dinhducqng/CDIO-4---Motor-3-Phase-AutoCad/bìa.docx

BỘ GIÓA DỤC VÀ DÀO TAO

TRƯỜNG ĐẠI HỌC DUY TÂN

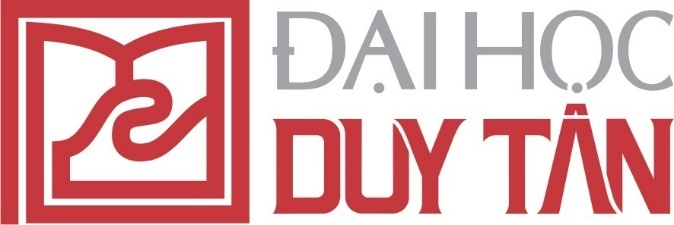
[picture p1: figure]

BÁO CÁO

Đề tài: “................................................................................................................

................................................................................................................................”

GVHD: ...................................

SVTH: …………………………………..

Lớp: …………………………………….

Khóa: …………………………………..

MSSV: ……………………………………
