dinhducqng/CDIO-4---Motor-3-Phase-AutoCad/demoooo.pdf

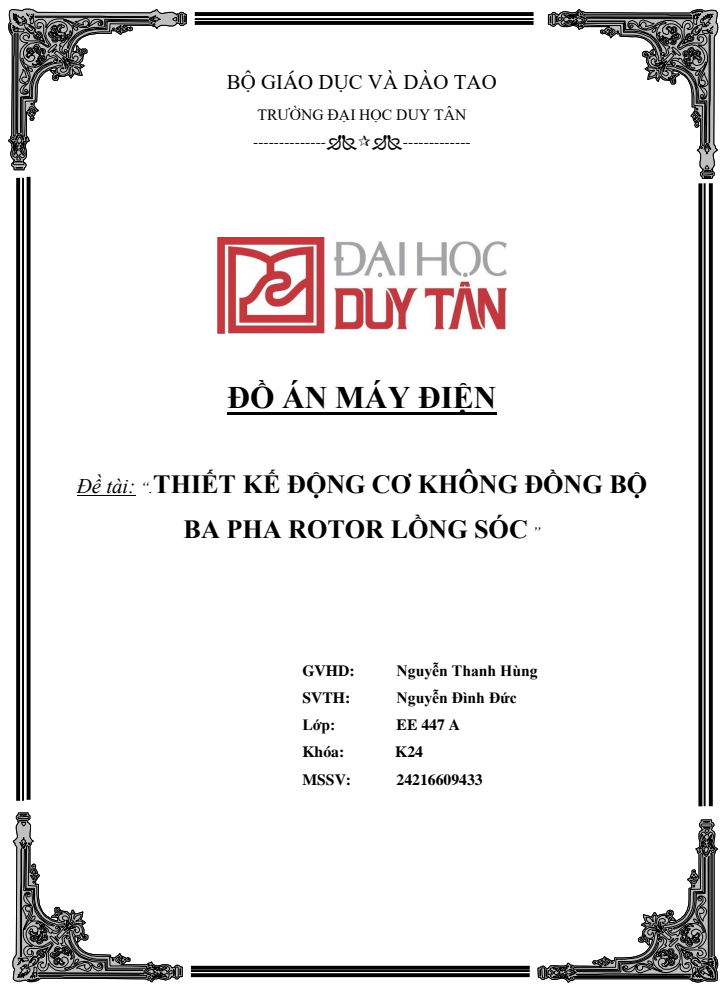
[picture p3: page 1]
GVHD:; Nguyễn Thanh Hùng; SVTH:; Nguyễn Đình Đức; Lớp:; Khóa:; MSSV:

BỘ GIÁO DỤC VÀ DÀO TAO

TRƯỜNG ĐẠI HỌC DUY TÂN

ĐỒ ÁN MÁY ĐIỆN

Đề tài: “.THIẾT KẾ ĐỘNG CƠ KHÔNG ĐỒNG BỘ

BA PHA ROTOR LỒNG SÓC ”

MỤC LỤC

1

LỜI NÓI ĐẦU

Động cơ không đồng bộ (KĐB) ba pha rôto lồng sóc được dùng phổ biến trong công

nghiệp (vì có ưu điểm là độ tin cậy tốt, giá cả thấp, trọng lượng nhẹ, kết cấu chắc chắn

và dễ bảo dưỡng), với dải công suất từ hàng trăm Watts đến vài Megawatts và là bộ

phận chính trong các hệ truyền động.

Ngày nay, hiệu suất của động cơ đã dần trở thành một trong những tiêu chí được áp

dụng trong công nghiệp. Vấn đề này đặt ra cho lĩnh vực thiết kế và chế tạo động cơ

điện là không ngừng nghiên cứu, thiết kế để tạo ra sản phẩm đạt những chỉ tiêu về

kinh tế - kỹ thuật nhằm đáp ứng yêu cầu phát triển của nền kinh tế quốc dân. Chính vì

vậy em đã chọn thực hiện đề tài : “ Thiết kế động cơ điện không đồng bộ ba pha rôto

lồng sóc” cho đồ án tốt nghiệp cuối khoá của mình.

Nôi dung đồ án gồm 7 chương:

Chương 1: Đại cương về động cơ điện không đồng bộ.

Chương 2: Xác định các kích thước chủ yếu.

Chương 3: Thiết kế stato.

Chương 4: Thiết kế rôto

Chương 5: Tính toán mạch từ và xác định tham số của động cơ ở chế độ định

mức.

Chương 6: Đặc tính làm việc và khởi động.

Chương 7: Trọng lượng vật liệu tác dụng và chỉ tiêu sử dụng.
Em xin bày tỏ lòng biết ơn các Thầy, Cô giáo mà đặc biệt là các Thầy cô giáo trong

khoa Điện – Điện Tử đã giúp đỡ chỉ bảo em tận tình trong những năm học tập tại trường Đại Học Duy Tân. Cho em gửi lời cảm ơn chân thành đến thầy giáo Nguyễn

Thanh Hùng – là người trực tiếp hướng dẫn em hoàn thành bản đồ án tốt nghiệp này.

Trong một khoảng thời gian ngắn chắc rằng bản đồ án tốt nghiệp sẽ không tránh khỏi

những thiếu sót. Em rất mong được sự chỉ dẫn của Thầy giáo, Cô giáo và các bạn. Em

xin chân thành cảm ơn.

Sinh viên

Nguyễn Đình Đức

2

CHƯƠNG 1

ĐẠI CƯƠNG VỀ ĐỘNG CƠ ĐIỆN KHÔNG ĐỒNG BỘ

### 1.1 TỔNG QUAN VỀ ĐỘNG CƠ ĐIỆN KHÔNG ĐỒNG BỘ

Máy điện không đồng bộ do kết cấu đơn giản, làm việc chắc chắn, sử dụng

và bảo quản thuận tiện, giá thành rẻ nên được sử dụng rộng rãi trong nền kinh tế

quốc dân, nhất là loại công suất dưới 100 kW.

Động cơ điện không đồng bộ rôto lồng sóc cấu tạo đơn giản, làm việc tin

cậy chiếm một số lượng khá lớn trong loại động cơ công suất nhỏ và trung bình.

Nhược điểm của động cơ này là điều chỉnh tốc độ khó khăn và dòng điện khởi

động lớn thường bằng 5-7 lần dòng điện định mức. Để bổ khuyết cho nhược điểm

này, người ta chế tạo đông cơ không đồng bộ rôto lồng sóc nhiều tốc độ và dùng

rôto rãnh sâu, lồng sóc kép để hạ dòng điện khởi động, đồng thời tăng mômen

khởi động lên.
Động cơ điện không đồng bộ rôto dây quấn có thể điều chỉnh tốc độ trong

một phạm vi nhất định, có thể tạo một mômen khởi động lớn mà dòng khởi động

không lớn lắm, nhưng chế tạo có khó hơn so với với loại rôto lồng sóc, do đó giá

thành cao hơn, bảo quản cũng khó hơn.
Động cơ điện không đồng bộ được sản xuất theo kiểu bảo vệ IP23 và kiểu

kín IP44. Những động cơ điện theo cấp bảo vệ IP23 dùng quạt gió hướng tâm đặt

ở hai đầu rôto động cơ điện. Trong các động cơ rôto lồng sóc đúc nhôm thì cánh

quạt nhôm được đúc trực tiếp lên vành ngắn mạch. Loại động cơ điện theo cấp

bảo vệ IP44 thường nhờ vào cánh quạt đặt ở ngoài vỏ máy để thổi gió ở mặt ngoài

vỏ máy, do đó tản nhiệt có kém hơn do với loại IP23 nhưng bảo dưỡng máy dễ

dàng hơn.
Hiện nay các nước đã sản xuất động cơ điện không đồng bộ theo dãy tiêu

chuẩn. Dãy động cơ không đồng bộ công suất từ 0,55 - 90 KW ký hiệu là K theo

tiêu chuẩn Việt Nam 1987-1994 được ghi trong bảng 10-1 [3]. Theo tiêu chuẩn

này, các động cơ điện không đồng bộ trong dãy điều chế tạo theo kiểu IP44.

3

Ngoài tiêu chuẩn trên còn có tiêu chuẩn TCVN 315-85, quy định dãy

công suất động cơ điện không đồng bộ rôto lồng sóc từ 110 kW-1000 kW, gồm

có công suất sau: 110,160, 200, 250, 320, 400, 500, 630, 800 và 1000 kW.

Ký hiệu của một động cơ điện không đồng bộ rôto lồng sóc được ghi theo

ký hiệu về tên gọi của dãy động cơ điện, ký hiệu về chiều cao tâm trục quay, ký

hiệu về kích thước lắp đặt.

### 1.1.1. Nguyên lý làm việc của động cơ điện không đồng bộ xoay chiều ba

pha.
Động cơ không đồng bộ bap ha có hai phần chính: stato (phần tĩnh) và

rôto (phần quay). Stato gồm có lõi thép trên đó có chứa dây quấn bap ha.

Khi đấu dây quấn ba pha vào lưới điện ba pha, trong dây quấn sẽ có các

dòng điện chạy, hệ thống dòng điện này tao ra từ trường quay, quay với tốc độ:

n1 = 60.

f1
p
Trong đó:
f1: tần số nguồn điện

p: số đôi cực từ của dây quấn

Phần quay, nằm trên trục quay bao gồm lõi thép rôto. Dây quấn rôto bao

gồm một số thanh dẫn đặt trong các rãnh của mạch từ, hai đầu được nối bằng

hai vành ngắn mạch.

Hình1.1

Từ trường quay của stato cảm ứng trong dây rôto sức điện động E, vì dây quấn stato kín mạch nên trong đó có dòng điện chạy, Sự tác dụng tương hổ

a

S

N

Fd

Fd

Ic n

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
giữa các thanh dẫn mang dòng điện với từ trường của máy tạo ra các lực điện từ

Fđt tác dụng lên thanh dẫn có chiều xác định theo quy tắc bàn tay trái.

Tập hợp các lực tác dụng lên thanh dẫn theo phương tiếp tuyến với bề măt rôto

tạo ra mômen quay rôto. Như vậy, ta thấy điện năng lấy từ lưới điện đã được

biến thành cơ năng trên trục động cơ. Nói cách khác, động cơ không đồng bộ là

một thiết bị điện từ, có khả năng biến điện năng lấy từ lưới điện thành cơ năng

đưa ra trên trục của nó. Chiều quay của rôto là chiều quay của từ trường, vì vậy

phụ thuộc vào thứ tự pha của điện áp lưới đăt trên dây quấn stato. Tốc độ của

rôto n2 là tốc độ làm việc và luôn luôn nhỏ hơn tốc độ từ trường và chỉ trong

trường hợp đó mới xảy ra cảm ứng sức điện động trong dây quấn rôto. Hiệu số

tốc độ quay của từ trường và rôto được đặc trưng bằng một đại lượng gọi là hệ

số trượt s:

s =

n1 − n2
n1
Khi s=0 nghĩa là n1= n2, tốc độ rôto bằng tốc độ từ trường, chế độ này gọi

là chế độ không tải lý tưởng (không có bất cứ sức cản nào lên trục). Ở chế độ

không tải thực, s≈0 vì có một ít sức cản gió, ma sát do ổ bi …

Khi hệ số trượt bằng s =1, lúc đó rôto đứng yên (n2=0), momen trên trục

bằng momen mở máy.

Hệ số trượt ứng với tải định mức gọi là hệ số trựơt định mức. Tương ứng

với hệ số trượt này gọi tốc độ động cơ gọi là tốc độ định mức.

Tốc độ động cơ không đồng bộ bằng:

n2 = n1. (1 − s)
Một đăc điểm quan trọng của động cơ không đồng bộ là dây quấn stato

không được nối trực tiếp với lưới điện, sức điện động và dòng điện trong rôto có

được là do cảm ứng, chính vì vậy người ta cũng gọi động cơ này là động cơ cảm

ứng.
Tần số dòng điện trong rôto rất nhỏ, nó phụ thuộc vào tốc độ trựơt của rôto so

với từ trường:

5

f2 = p.

n1 − n2
60 =

p. n1. (n1 − n2)
60. n1

= s. f1

Động cơ không đồng bộ có thể làm việc ở chế độ máy phát điện nếu ta

dùng một động cơ khác quay nó với tốc độ cao hơn tốc độ đồng bộ, trong khi

các đầu ra của nó được nối với lưới địện. Nó cũng có thể làm việc độc lập nếu

trên đầu ra của nó được kích bằng các tụ điện.

Động cơ không đồng bộ có thể cấu tạo thành động cơ một pha. Động cơ

một pha không thể tự mở máy được, vì vậy để khởi động động cơ một pha cần

có các phần tử khởi động như tụ điện, điện trở …

### 1.1.2. Cấu tạo của động cơ không đồng bộ

Động cơ không đồng bộ về cấu tạo được chia làm hai loại: Động cơ

không đồng rôto lồng sóc và động cơ rôto dây quấn. Stato của hai loại là như

nhau. Ở phần đồ án này ta chỉ nghiên cứu rôto lồng sóc .

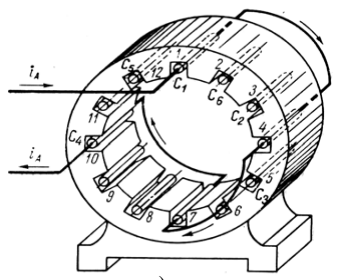
[picture p4: figure]
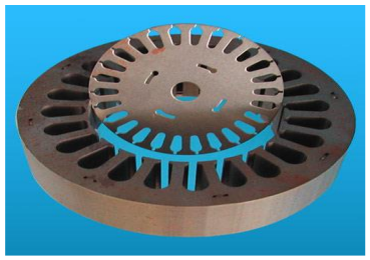
[picture p5: figure]

a) b)
Hình 1.2 kết cấu stato máy điện không đồng bộ
a) lá thép stato
b) lõi thép stato.
a) Stato (phần tĩnh)

Stato bao gồm vỏ máy, lõi thép và dây quấn.

- Vỏ máy
Vỏ máy là nơi cố định lõi sắt, dây quấn và đồng thời là nơi ghép

nối nắp hay gối đỡ trục. Vỏ máy có thể làm bằng gang, nhôm hay thép.

6

Để chế tạo vỏ máy người ta có thể đúc, hàn, rèn. Vỏ máy có hai

kiểu: vỏ kiểu kín và vỏ kiểu bảo vệ. Vỏ máy kiểu kín yêu cầu phải có

diện tích tản nhiệt lớn người ta làm nhiều gân tản nhiệt trên bề mặt vỏ

máy. Vỏ kiểu bảo vệ thường có bề mặt ngoài nhẵn, gió làm mát thổi trực

tiếp trên bề mặt ngoài lõi thép và trong vỏ máy.

Hộp cực là nơi để dấu điện từ lưới vào. Đối với động cơ kiểu kín

hộp cực yêu cầu phải kín, giữa thân hộp cực và vỏ máy với nắp hộp cực

phải có giăng cao su. Trên vỏ máy còn có bulon vòng để cẩu máy khi

nâng hạ, vận chuyển và bulon tiếp mass.

- Lõi sắt

Lõi sắt là phần dẫn từ. Vì từ trường đi qua lõi sắt là từ trường quay,

nên để giảm tổn hao lõi sắt được làm từ những lá thép kỹ thuật điện dày

0,5mm bề mặt các lá thép có phủ một lớp sơn cách điện mỏng để giảm

tổn hao do dòng điện xoáy gây nên, các lá thép được ép lại thành khối.

Yêu cầu lõi sắt là phải dẫn từ tốt, tổn hao sắt nhỏ và chắc chắn.

- Dây quấn

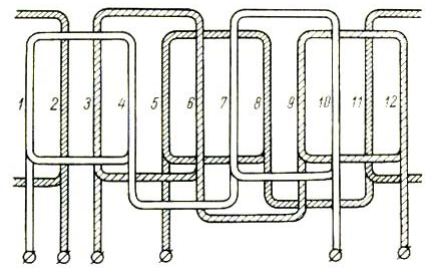
[picture p6: figure]

Hình 1.3. Dây quấn stato.

Dây quấn stato được đặt vào rãnh của lõi sắt và được cách điện tốt với lõi

sắt. Dây quấn đóng vai trò quan trọng của máy điện vì nó trực tiếp tham gia các

quá trình biến đổi năng lượng điện năng thành cơ năng hay ngược lại, đồng thời

7

về mặt kinh tế thì giá thành của dây quấn cũng chiếm một phần khá cao trong

toàn bộ giá thành máy.
b) Phần quay (Rôto)

Rôto của động cơ không đồng bộ gồm lõi sắt, dây quấn và trục (đối với

động cơ rôto dây quấn còn có vành trượt).

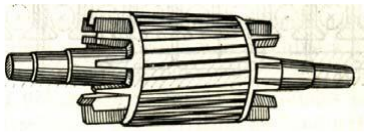
[picture p7: figure]

a) b )
Hình 1.4. Cấu tạo rôto động cơ không đồng bộ.
a) Dây quấn lồng sóc. b) Lõi thép rôto;

Lõi sắt

Lõi sắt của rôto bao gồm các lá thép kỹ thuật điện như của stato,

điểm khác biệt ở đây là không cần sơn cách điện giữa các lá thép vì tần số

làm việc trong rôto rất thấp, chỉ vài Hz, nên tổn hao do dòng phu co trong

rôto rất thấp. Lõi sắt được ép trực tiếp lên trục máy hoặc lên một giá rôto

của máy. Mặt ngoài của lõi thép đựợc dập rãnh (hình 1.2b) để đặt dây

quấn và ở giữa có dập lỗ để lắp trục.

Dây quấn rôto

Phân làm 2 loại chính: loại kiểu rôto dây quấn và loại kiểu rôto

lồng sóc.

Loại rôto dây quấn

Rôto dây quấn giống như giây quấn stato. Máy điện kiểu trung

bình trở lên dùng dây quấn kiểu sóng 2 lớp, vì bớt những giây đầu nối,

kết cấu trên dây quấn rôto trở nên chặt chẽ. Máy điện cỡ nhỏ dùng dây

quấn đồng tâm 1 lớp. Dây quấn 3 pha của rôto thường đấu hình sao.

8

Đặt điểm của loai động cơ kiểu dây quấn có thể thông qua chổi

than để đưa điện trở phụ hay suất điện động phụ vào mạch rôto để

tạo tính năng mở máy, điều chỉnh tốc độ hay cải thiện hệ số công

suất của máy.

Loại rôto lồng sóc

Kết cấu của loại dây quấn này rất khác với dây quấn stato (hình

1.4a). Trong mỗi rãnh của lõi sắt rôto, đặt các thanh dẫn bằng đồng hay

nhôm dài khỏi lõi sắt và được nối tắt lại ở hai đầu bằng hai vòng ngắn

mạch bằng đồng hay nhôm. Nếu là rôto đúc nhôm thì trên vành ngắn

mạch còn có các cánh khoáy gió.
Rôto thanh đồng được chế tạo từ đồng hợp kim có điện trở suất cao

nhằm mục đích nâng cao mô men mở máy và giảm tổn hao.

Để cải thiện tính năng mở máy, đối với máy có công suất lớn,

người ta làm rãnh rôto sâu hoặc dùng lồng sóc kép. Đối với máy điện cỡ

nhỏ, rãnh rôto được làm chéo góc so với tâm trục.
Dây quấn lồng sóc không cần cách điện với lõi sắt.

Trục

Trục máy điện mang rôto quay trong lòng stato, vì vậy nó cũng là một chi tiết rất quan trọng. Trục của máy điện tùy theo kích thước có thể

được chế tạo từ thép cacbon từ 5 đến 45.

Trên trục của rôto có lõi thép, dây quấn, và quạt gió.

### 1.1.3. Khe hở

Vì rôto là một khối tròn nên khe hở đều. Khe hở trong máy điện

không đồng bộ rất nhỏ (0,2÷1 mm trong máy cỡ nhỏ và vừa) để hạn chế

dòng từ hóa, nhờ đó hệ số công suất của máy cao hơn.

### 1.1.4 Phân loại:

Kết cấu của những máy điện hiện nay được định hình theo cách

bảo vệ, cách lắp ghép, thông gió, đặc tính của môi trường bên ngoài…

9

a) Phân loại theo phương pháp bảo vệ máy đối với môi trường bên ngoài

Cấp bảo vệ máy có ảnh hưởng rất lớn đến kết cấu của máy. Cấp bảo vệ được

ký hiệu bằng chữ IP và hai chữ số kèm theo, trong đó chữ số thứ nhất chỉ mức

độ bảo vệ chống sự tiếp xúc của người và các vật khác rơi vào máy, được chia

làm 7 cấp đánh số từ 0 đến 6 ,trong đó số 0 chỉ rằng máy không được bảo vệ

(kiểu hở hoàn toàn) còn số 6 chỉ rằng máy được bảo vệ hoàn toàn không cho

người tiếp xúc ,đồ vật và bụi không lọt vào, chữ số thứ hai chỉ mức độ bảo vệ

chống nước vào máy gồm cấp đánh số từ 0 đến 8, trong đó số 0 chỉ rằng máy

không được bảo vệ còn số 8 chỉ máy có thể ngâm trong nước trong thời gian vô

hạn định.
Thường có thói quen chia cấp bảo vệ theo phương pháp làm nguội máy.

Theo cách này máy điện được chia thành các kiểu kết cấu sau:

Kiểu hở

Loại này không có trang bị bảo vệ sự tiếp xúc tự nhiên các bộ phận

quay và bộ phận mang điện, cũng không có trang bị bảo vệ các vật bên ngoài rơi vào máy. Loại này được chế tạo theo kiểu tự làm nguội. Theo cấp

bảo vệ thì đây là loại IP00. Loại này thường đặt trong nhà có người trông coi và không cho người ngoài đến gần.

Kiểu bảo vệ

Có trang bị bảo vệ chống sự tiếp xúc ngẫu nhiên các bộ phận quay

hay mang điện, bảo vệ các vật ở ngoài hoặc nước rơi vào theo các góc độ khác nhau. Loại này thường là tự thông gió. Theo cấp bảo vệ thì kiểu này

thuộc các cấp bảo vệ từ IP11 đến IP33

Kiểu kín

Là loại máy mà không gian bên trong máy và môi trường bên ngoài máy được cách ly. Tùy theo mức độ kín mà cấp bảo vệ là từ IP44 trở lên.

Kiểu kín thường là tự thông gió bằng cách thổi gió ở mặt ngoài vỏ máy hay

thông gió độc lập bằng cách đưa gió vào trong máy bằng đường ống.

Thừơng dùng loại này ở môi trường nhiều bụi, ẩm ướt …

10

Kiểu bảo vệ đặc biệt như loại chống nổ, bảo vệ chống môi trường hóa

chất.

b) Phân loại theo cách lắp đặt

Theo cách lắp đặt máy, ký hiệu chữ IM kèm theo 4 chữ số tiếp theo. Ở

đây, chữ số thứ nhất chỉ kiểu kết cấu gồm 9 số đánh từ 1 đến 9 trong đó số 1 chỉ

ổ bi được lắp trên nắp máy và số 9 chỉ cách lắp đặt biệt. Chữ số thứ hai và ba

chỉ cách thức lắp đặt và hướng của trục máy. Số thứ tư chỉ kết cấu của đầu trục

gồm 9 loại đánh số từ 0 đến 8 trong đó số 0 chỉ máy có một đầu trục hình trụ, số

8 chỉ đầu trục có các kiểu đặc biệt khác.

### 1.1.5. Công dụng

Máy điện không đồng bộ là máy điện chủ yếu dùng làm động cơ điện. Do

kết cấu đơn giản, làm việc chắc chắn, hiệu quả cao, giá thành rẻ, dễ bảo quản …

Nên động cơ không đồng bộ là loại máy điện được sử dụng rộng rãi nhất trong

các ngành kinh tế quốc dân với công suất vài chục W đến hàng chục kW. Trong

công nghiệp thường dùng máy điện không đồng bộ làm nguồn động lực cho

máy cán thép loại vừa và nhỏ, động lực cho các máy công cụ ở các nhà máy công nghiệp nhẹ… Trong hầm mỏ dùng làm máy tưới hay quạt gió. Trong nông

nghiệp dùng làm máy bơm hay máy gia công nông phẩm. Trong đời sống hàng

ngày, máy điện không đồng bộ cũng đã chiếm một vị trí quan trọng như quạt

gió, động cơ trong tủ lạnh, máy giặt, máy bơm nước … nhất là loại rôto lồng

sóc. Tóm lại sự phát triển của nền sản suất điện khí hóa, tự động hóa và sinh

hoạt hằng ngày, phạm vi của máy điện không bộ ngày càng được rộng rãi.

Máy điện không đồng bộ có thể dùng làm máy phát điện, nhưng đặc tính

không tốt so với máy điện đồng bộ, nên chỉ trong vài trường hợp nào đó (như

trong quá trình điện khí hóa nông thôn) cần nguồn điện phụ hay tạm thời thì nó

cũng có một ý nghĩa rất quan trọng.

### 1.1.6. Các đại lượng định mức

Cũng như tất cả các loại động cơ điện khác, động cơ điện không đồng bộ

có các trị số định mức đặc trưng cho đều kiện kỹ thuật của máy. Các trị số này

11

do nhà máy thiết kế, chế tạo quy định ghi trên nhãn máy. Vì động cơ điện không

đồng bộ chủ yếu làm việc ở chế độ động cơ điện nên trên nhãn máy ghi các trị

số định mức của động cơ điện khi tải định mức. Các trị số đó thường bao gồm:

Công suất có ích trên trục | Pđm
Điện áp dây stato | U1đm
Dòng điện dây stato | I1đm
Tần số dòng điện stato | f
Tốc độ quay rôto | nđm
Hệ số công suất | cosρdm
Hiệu suất | ηdm

### 1.2 YÊU CẦU CỦA THIẾT KẾ ĐỘNG CƠ KĐB BA PHA RÔTO LỒNG

SÓC.

### 1.2.1. Nhiệm vụ và phạm vi thiết kế:

Nhiệm vụ thiết kế được xác định từ hai yêu cầu sau :

Yêu cầu từ phía nhà nước, bao gồm các tiêu chuẩn nhà nước, các yêu cầu

kỹ thuật do nhà nước quy định.
Yêu cầu từ phía nhà máy và người tiêu dùng thông qua các hợp đồng ký

kết.

Nhiệm vụ của người thiết kế là đảm bảo tính năng kỹ thuật của sản phẩm

đạt các tiêu chuẩn nhà nước quy định để tìm khả năng hạ giá thành để đạt

hiệu quả kinh tế cao nhất, nói tóm lại là đạt chỉ tiêu kinh tế kỹ thuật cao.

### 1.2.2. Các bước thiết kế gồm có :

Thiết kế điện từ :

Nhiệm vụ của tính toán điện từ một động cơ điện không đồng bộ rôto

lồng sóc là lựa chọn và tính toán kích thước của lõi sắt stato, rôto, kích thước

dây quấn sao cho máy đạt được tính năng mà tiêu chuẩn đã quy định. Trong giai

đoạn này, người thiết kế xác định một phương án điện từ hợp lý, có thể tính

bằng tay, có thể nhờ vào máy tính. Quá trình này sẽ tiến hành tính toán, thiết kế

các thành phần:

12

Xác định các kích thước chủ yếu.

Thiết kế stato.

Thiết kế rôto.

Xác định tham số của động cơ điện ở chế độ định mức.

Tính toán đặc tính làm việc và khởi động.
Thiết kế kết cấu:

Trong giai đoạn này phải tiến hành tính toán nhiệt để xác định kết

cấu cụ thể về phương thức thông gió và làm nguội, kết cấu cụ thể

về cách bôi trơn ổ đỡ, kết cấu thân máy và nắp máy.

Để chế tạo được động cơ không đồng bộ rôto lồng sóc còn phải qua các

khâu thiết kế sau :

Thiết kế thi công, có nhiệm vụ vẽ tất cả các bản vẽ lắp ráp và chi

tiết.

Thiết kế khuôn mẫu và gá lắp dùng trong gia công các chi tiết của

máy.
Thiết kế công nghệ, dùng để kiểm tra công nghệ trong quá trình gia

công.

### 1.2.3. Vật liệu thường dùng trong thiết kế :

Khi thiết kế động cơ không đồng bộ rôto lồng sóc, vấn đề chọn vật liệu

để chế tạo động cơ có một vai trò rất quan trọng và ảnh hưởng rất lớn đến giá

thành và tuổi thọ làm việc của nó.

Ta có các loại vật liệu sau:
a. Vật liệu dẫn từ:

Để chế tạo các phần của hệ thống mạch từ của động cơ, người ta thường

dùng các loại thép lá kỹ thuật điện hay còn gọi là tôn silíc. Hàm lượng silíc trong thép lá kỹ thuật điện có ảnh hưởng quyết định đến tính năng của nó. Cho

silíc vào thép có thể làm cho điện trở suất tăng cao, do đó hạn chế được dòng

điện xoáy nên tổn hao thép sẽ thấp xuống, nhưng khi có silíc thì cường độ từ

13

cảm cũng hạ thấp, độ cứng và độ giòn cũng tăng lên, vì vậy lượng silíc trong

thép nói chung không vượt quá 4,5%.
Trong lõi thép có từ trường biến thiên, khi mật độ từ thông và tần số biến

thiên không đổi thì tổn hao vì dòng điện xoáy của đơn vị thể tích lõi thép

tỷ lệ bình phương với chiều dày lá thép, vì vậy trong đại bộ phận máy

điện đều dùng tôn silíc dày 0,5mm. Chỉ trong trường hợp đặc biệt mới

dùng tôn dày 0,35mm.

Tùy theo công nghệ cán, người ta chia tôn silíc thành 2 loại:
Tôn cán nóng: Loại tôn này có lịch sử lâu đời, hiện nay vẫn còn sản xuất

nhiều. Tùy theo hàm lượng silíc mà người ta phân ra loại ít silíc (

và nhiều silíc (>2,8%).

Tôn cán nguội: So với tôn cán nóng, tôn cán nguội có nhiều ưu điểm như

tổn hao nhỏ, cường độ từ cảm cao, chất lượng bề mặt tốt, độ bằng phẳng

tốt nên hệ số ép chặt lá tôn cao, có thể sản xuất thành cuộn, do đó các

nước phát triển đều dùng tôn cán nguội thay thế tôn cán nóng. Tùy theo

sự sắp xếp các tinh thể silíc trong tôn cán nguội mà phân thành hai loại:

đẳng hướng và dị hướng. Ở tôn silíc cán nguội dị hướng thì theo chiều

cán, suất dẫn từ cao (với cường độ từ trường H = 25A/cm, mật độ từ

thông B có thể đạt 1,7-1,85T), suất tổn hao nhỏ, nhưng theo chiều vuông

góc với chiều cán thì tính năng kém đi nhiều, có khi không bằng cả tôn

cán nóng.
b. Vật liệu dẫn điện:

Trong ngành chế tạo máy điện, người ta chủ yếu dùng đồng tinh

khiết với tạp chất không quá 0,1% làm vật liệu dẫn điện vì điện trở suất

của đồng chỉ kém bạc. Ngoài đồng ra còn dùng nhôm với tạp chất không

quá 0,5%, đồng thau và đồng đen.

c. Vật liệu kết cấu
- Kim loại đen:

≤ 2,8%)

14

Kim loại đen thường dùng là gang và thép. Gang vừa rẻ tiền lại dễ đúc,

do đó được dùng nhiều, nhất là dùng để đúc các hình mẫu phức tạp như vỏ và

nắp máy điện không đồng bộ.

Thép dùng làm vật liệu kết cấu thường là thép định hình. Thép có tiết

diện tròn dùng để chế tạo trục máy và các chi tiết khác có tiết diện tròn. Tùy

theo lực tác dụng lên từng chi tiết của máy mà người ta dùng nhiều loại thép

khác nhau.

- Kim loại màu:
Thường dùng hợp kim nhôm để chế tạo các chi tiết và bộ phận của máy

mà trọng lượng cần giảm tối đa.

- Vật liệu chất dẻo:

Chất dẻo hiện nay được dùng nhiều để chế tạo các chi tiết trong máy điện

ít chịu lực cơ học và nhiệt. Chất dẻo có ưu điểm là nhẹ, dễ gia công và không bị

gỉ.

d.Vật liệu cách điện:
Vật liệu cách điện là một trong những vật liệu chủ yếu dùng để chế tạo

động cơ. Khi thiết kế động cơ, chọn vật liệu cách điện là một khâu rất quan

trọng vì phải đảm bảo động cơ làm việc tốt với tuổi thọ nhất định, đồng thời giá

thành của nó lại không cao. Khi chọn vật liệu cách điện cần chú ý những điểm

sau:
Vật liệu cách điện phải có độ bền cao, chịu tác dụng về cơ học tốt, chịu

nhiệt và dẫn điện tốt lại ít thấm nước.

Gia công dễ dàng, đủ mỏng để đảm bảo hệ số lấp đầy rãnh cao.

Phải chọn vật liệu cách điện có tính cách điện cao để đảm bảo thời gian

làm việc ít nhất của máy là 15-20 năm trong điều kiện làm việc bình thường,

đồng thời đảm bảo giá thành của động cơ không cao.

Một trong những yếu tố cơ bản nhất làm giảm tuổi thọ của vật liệu cách

điện là nhiệt độ. Nếu nhiệt độ vượt quá nhiệt độ cho phép thì chất điện môi, độ

bền cơ của vật liệu giảm đi nhiều, dẫn đến sự già hóa nhanh chất cách điện.

15

### 1.3. CÁC THÔNG SỐ BAN ĐẦU

Công suất định mức: Pđm = 4kW

Điện áp định mức: Uđm = 380/220V Tần số định mức: fđm = 50Hz

Cách đấu dây: Y/Δ

Tốc độ đồng bộ: n1 = 3000 vòng/phút

Kiểu máy: Máy kiểu kín

Cấp bảo vệ: IP44

Cấp cách điện: Cách điện cấp B

Chế độ làm việc: Liên tục

Kết cấu rôto: Rôto lồng sóc

Chiều cao tâm trục:

Tra Bảng IV. 2, phụ lục IV [3] chiều cao tâm trục theo dãy công

suất của động cơ điện KĐB rôto lồng sóc 4A (Nga) kiểu IP44 cấp cách

điện B là h = 112 mm
Hiệu suất và hệ số công suất:

Tra Bảng 10-1 [3] hiệu suất và cosφ dãy động cơ điện KĐB 3K ứng với

công suất Pđm=4 kW và tốc độ nđb=3000 vòng/phút ta có hiệu suất:η =

86,5% và hệ số công suất: Cosφ = 0,89

Bội số momen cực đại:

Tra bảng 10-10 [3] bội số momen cực đại mmax của dãy động cơ 3K ta có:

mmax =

Mmax

Mđm

= 2,2

Bội số momen khởi động:

Theo bảng 10-11 [3] bội số momen khởi động dãy động cơ điện 3K ta

chọn:

mk =

Mk

Mđm

= 2

Bội số dòng khởi động:

Tra bảng 10-12 [3 ] bội số dòng khởi động dãy động cơ điện 3K ta có:

16

ik= Imax/I đm=7,5

17

CHƯƠNG 2

XÁC ĐỊNH CÁC KÍCH THƯỚC CHỦ YẾU

Những kích thước chủ yếu của động cơ điện không đồng bộ là đường

kính trong stato D và chiều dài lõi sắt l. Mục đích của việc chọn kích thước này

là để chế tạo ra máy kinh tế hợp lý nhất mà tính năng phù hợp với tiêu chuẩn

nhà nước. Tính kinh tế của máy không chỉ là vật liệu sử dụng đểû chế tạo ra

máy mà còn xét đến quá trình chế tạo trong nhà máy, như tính thông dụng của

các khuông dập ,vật đúc, các kích thước và chi tiết tiêu chuẩn hoá …

### 2.1. Số đôi cực từ ( p ):

p =

60.f
n1

=

60.50
3000

= 1

trong đó:
n1 : Tốc độ đồng bộ (vòng/phút)

f : tần số (Hz)

### 2.2. Đường kính ngoài stator (Dn):

Đường kính ngoài Dn có liên quan mật thiết với kết cấu động cơ, cấp cách

điện và chiều cao tâm trục h đã được tiêu chuẩn hóa. Vì vậy thường chọn Dn

theo h. Ở nước ta hay dùng quan hệ giữa đường kính ngoài và chiều cao tâm

trục h của các động cơ điện không đồng bộ Hungary dãy VZ cách điện cấp E và

của Nga dãy 4A cách điện cấp F.

Với chiều cao tâm trục h = 112 mm. Theo bảng 10.3 [1] ta có đường kính

chuẩn:

Dn = 170 (mm)= 17,0 (cm)

### 2.3. Đường kính trong stato ( D):

Ta có: D = kD . Dn

Theo bảng 10.2 với 2p = 2 ta có kD = 0,52 ÷ 0,58

Vậy:

| D = kD . Dn = ( 0,52 ÷ 0,58 ) .17 = 8,84 ÷ 9,86 (cm)
| Chọn: D = 9,8 (cm)

18

### 2.4. Công suất tính toán (P') :

P' = kE.P
η.cos φ

=

0,98.4
0,865.0,89

= 5,091 (kW)

Trong đó :
kE là hệ số công suất định mức.

Chọn kE = 0,98 theo hình 10-2 [1].

### 2.5. Chiều dài của lõi sắt stato (l1):

Chiều dài của lõi sắt stato được xác định:

l1 =

6,1.10

7
. P

′
αδ. ks

. kd. A. Bδ.D². n

trong đó:
kd : hệ số dây dẫn

αδ : hệ số cung cực từ

ks : hệ số dạng sóng

A : Tải điện từ

Bδ : Mật độ từ thông khe hở không khí

Chọn sơ bộ :

kd = 0,9 , theo trang 231 [1]

αδ =

2
π

= 0,64

kS =

π
2√2

= 1,11

Việc chọn A và Bδ ảnh hưởng rất nhiều đến kích thước chủ yếu của D và

l. Đứng về mặt tiết kiệm vật liệu thì nên chọn A và Bδ lớn, nhưng nếu A và Bδ

quá lớn thì tổn hao đồng và sắt tăng lên, làm máy quá nóng, ảnh hưởng đến tuổi

thọ sử dụng máy. Do đó khi chọn A và Bδ cần xét đến chất liệu vật liệu sử dụng.

Nếu sử dụng vật liệu sắt từ tốt (có tổn hao ít hay độ từ thẩm cao) thì có thể chọn

Bδ lớn. Dùng dây đồng có cấp cách điện cao thì có thể chọn A lớn. Ngoài ra tỷ

số giữa A và Bδ củng ảnh hưởng đến đặt tính làm việc và khởi động của động

cơ không đồng bộ, vì A đặt trưng cho mạch điện , Bδ đặt trưng cho mạch từ.

19

Tra bảng 10-3a [1], chọn: A = 244 (A/cm) ; Bδ = 0,59 (T) Thay các giá trị vào biểu thức:

l1 =

6,1.10

7
.P′
ασ.kS.kd.A.Bσ.D².n

=

6,1.10

7
.5,091
0,64.1,11.0,9.0,59.244.9,8

2.3000

= 11,71 (cm)

Chọn l1 = 11,7 (cm)
Do lõi sắt ngắn nên làm thành 1 khối nên chiều dài lõi sắt stato, rôto

bằng: l1 = l2 = lδ = 11,7 (cm)

### 2.6. Bước cực (τ):

τ =

π. D
2. p

=

π. 9,8
2.1

= 15,393 (cm)

### 2.7. Dòng điện pha định mức:

I1 =

P. 10

3
3. U1. η. cos φ

=

4.10

3
3.220.0,865.0,89 = 7,872 (A)

trong đó:
P: Công suất định mức (kW)

U1: điện áp định mức
η: hiệu suất

cosφ : hệ số công suất

20

CHƯƠNG 3

THIẾT KẾ STATO

### 3.1. Số rãnh stato (Z1):

Khi thiết kế dây quấn stato cần phải xác định số rãnh của một pha dưới

mỗi cực q1. Nên chọn q1 trong khoản từ 2 đến 5, thường lấy q1= 3 - 4.Với máy

công suất nhỏ hoặc tốc độ thấp, lấy q1 = 2. Máy tốc độ cao công suất lớn có thể

chọn q1 = 6. Chọn q1 nhiều hay ít có ảnh hưởng đến số rãnh stato Z1. Số rãnh

này không nên nhiều quá, vì vậy diện tích cách điện rãnh chiếm chỗ so với số

rãnh ít sẽ nhiều hơn, do đó hệ số lợi dụng rãnh sẽ giảm đi. Mặt khác về phương

diện độ bền cơ mà nói răng sẽ yếu. Ít răng quá sẽ làm cho dây quấn phân bố

không đều trên bề mặt lõi sắt nên sức từ động phần ứng có nhiều sóng bật cao.

Trị số q1 nên chọn theo số nguyên vì cải thiện dược đặt tính làm việc và

khả năng làm giảm tiếng kêu của máy. Chỉ trong trường hợp không thể tránh

được mới dùng q1 với mẫu số phân bố là 2 sở dĩ như vậy là vì sức từ động sóng

bật cao và sóng răng của dây quấn với q là phân bố trong động cơ điện không

đồng bộ là máy có sự phân bố nhỏ, dễ sinh ra rung, mômen phụ làm tăng tổn

hao phụ.
Số rãnh stato :

Z1 = 2. m. p. q1

trong đó:
m : số pha

q1 : số rãnh của một pha dưới mỗi cực. Lấy q1 = 6

p : số đôi cực từ,

p = 1 thay vào ta được
Z1 = 2. m. p. q1 = 2.3.1.6 = 36 (rãnh)

### 3.2. Bước rãnh stato (t1):

t1 =

π.D
Z1

=

π.9,8
36

= 0,855(cm)

21

### 3.3. Số thanh dẫn tác dụng của một rãnh (ur1):

ur1 =

At1a1
I1

=

244.0,855.2
7,872 = 53

Lấy: ur1 = 54

trong đó:
a1 là số mạch nhánh song song, chọn a1 = 2.

I1 :Dòng điện định mức, tính ở 2.7

### 3.4. Số vòng dây nối tiếp của 1 pha (w1):

w1 = p. q1.

ur1
a1

= 1.6.

54
2

= 162 (vòng)

### 3.5. Tiết diện dây dẫn (s1):

Muốn chọn kích thước dây trước hết phải chọn mật độ dòng điện J của

dây dẫn. Căn cứ vào dòng điện định mức để tính ra tiết diện tiết diện cần thiết.

Việc chọn ra mật độ dòng điện ảnh hưởng đến hiệu suất và sự phát nóng của

máy mà sự phát nóng này chủ yếu phụ thuộc vào tích số AJ. Tích số này tỷ lệ

với suất tải nhiệt của máy. Do đó theo kinh nghiệm thiết kế chế tạo, người ta

căn cứ vào cấp cách điện để xác định AJ.

Theo hình 10-4 [1] ta chọn tích số : AJ =1300 (A²
| / cm.mm² )

Sơ bộ mật độ dòng điện (J'1):

J1

′ =

A.J
A

=

1300

244 = 5,327( | A
| mm² )

trong đó:
n1: số sợi chập, chọn n1 = 2 sợi

S1

′ =

I1
a1. n1.J1

′ =

7,872
2.2.5,327 = 0,369(mm²
)

Theo bảng VI.1 [1]. Chọn dây đồng tráng men PETV có các thông số:

d / dcđ = 0,69 / 0,75 (mm); S = 0,374 (mm² )

Với:
d: đường kính dây không kể cách điện (mm)

dcd: đường kính dây kể cả cách điện (mm)

S: tiết diện dây (mm²
)

22

### 3.6. Kiểu dây quấn:

Dây quấn stato đặt vào rãnh của lõi thép stato và được cách điện với lõi

thép. Dây quấn có nhiệm vụ cảm ứng được sức điện động nhất định, đồng thời

cũng tham gia vào việc chế tạo nên từ trường cần thiết cho sự biến đổi năng

lượng điện có trong máy.
Các yêu cầu của dây quấn:

Đối với dây quấn ba pha điện trở và điện kháng của các pha bằng

nhau và của mạch nhánh song song cũng bằng nhau.

Dây quấn được thực hiện sao cho có thể đấu thành mạch nhánh

song song một cách dễ dàng.

Dây quấn được chế tạo và thiết kế sao cho tiết kiệm được lượng đồng, dễ

chế tạo, sữa chữa, kết cấu chắc chắn, chịu được ứng lực khi máy bị ngắn mạch

đột ngột.
Việc chọn dây quấn stato phải thỏa mãn tính kinh tế và kỹ thuật:

Tính kinh tế: tiết kiệm vật liệu dẫn điện, vật liệu cách điện, thời gian lồng

dây.
Tính kỹ thuật: dễ thi công, hạn chế những ảnh hưởng xấu đến đặc tính

điện của động cơ.
Từ yêu cầu trên ta chọn dây quấn hai lớp dạng xếp bối dây bước ngắn.

Công dụng là để giảm lượng đồng sử dụng,khử sóng bậc cao, giảm từ trường

tản ở phần bối dây và trong rãnh stato, làm tăng cosφ, cải thiện đặc tính mở máy

động cơ, giảm tiếng ồn điện từlúc động cơ vận hành.

Các hệ quả xấu tồn tại trong động cơ khi sóng bậc cao không bị khử:

Tính năng mở máy xấu do các trường trên đặc tuyến momen (do sóng bậc

5 và 7 gây ra) làm cho động cơ không đạt đến tốc độ định mức.

Nếu số răng của stato và roto không phù hợp động cơ gây ra tiếng ồn điện

từ khi vận hành, có khi roto bị hút lệch tâm (do lực hút điện từ tạo nên).
Sóng bậc cao gây tổn hao nhiệt trong lõi thép dưới tác dụng do dòng

phuco.

23

Thực ra việc chọn bước ngắn thích hợp không có tác dụng khử hoàn toàn

các sóng bậc cao mà chỉ có tác dụnggiảm nhỏ chúng xuống đến một giá trị chấp

nhận được. Trong thiết kế, bước bối dây có tác dụng khử sóng bậc 5 vá 7 cách

đấu dây hình sao ba pha có tác dụng khử sóng bậc 3.

Tiêu chuẩn xét sự tổn hao sóng bậc cao ≤ 5% xem như sóng bậc cao không

đáng kể, từ 5-10% chấp nhận được, >10% có tồn tại sóng bâc cao. Sóng bậc cao

không bị khử không cho phép khả thi.

Để khử triệt hoàn toàn sóng bậc 3 ta dùng hệ số β =

2
3

, khử sóng bậc 5 ta

dùng hệ số β =

4
5

, khử sóng bậc 7 ta dùng hệ số β =

6
7

.Tuy nhiên ta không khử

triệt hoàn toàn một sóng bậc cao nào cả mà ta chọn bước bối dây để làm nhỏ các

sóng bậc cao 3, 5, 7 cùng một lúc.
β = y1
τ1

=

15
18

= 0,833

Trong đó:

τ1 =

Z1
2.p

=

36
2.1

= 18 (rãnh) là bước cực từ

y1 là bước bối dây Þ chọn ymin ≤ y1 ≤ ymax

ymin =

2
3

. τ1 =

2
3

.18 = 12

ymax = τ1-1 = 18-1 = 17

Þ ta chọn y1 = 15

### 3.7. Hệ số dây quấn (kd):

Hệ số bước ngắn : ky = sinβ.

π
2

= sin( ¹⁵
18

π
2

) = 0,966

Hệ số bước rải:

kr =

sin q1 .

α
2
q1. sin α
2

=

sin 6 .

10
2
6. sin 10
2

= 0,956

Hệ số dây quấn: | kd = kr.ky = 0,923
Trong đó | α = p.360 Z1 =
| 1.360
| 36 = 10

0


24

Hình 3.1: Sơ đồ quấn dây động cơ.

### 3.8. Từ thông khe hở không khí (φ ):

Φ =

kE. U
4. ks

. kd. f. w1

=

0,98.220
4.1,11.0,923.50.162 = 0,006495 (Wb)

trong đó:
w1 : số vòng dây nối tiếp một pha, được xác định ở 3.4

kd : hệ số dây quấn, xác định ở 3.7

### 3.9. Mật độ từ thông khe hở không khí (Bδ):

Bδ =

Φ. 10

4
αδ. τ. l1

=

0,006495.10

4
0,64.15,393.11,7

= 0,563(T)

trong đó:
αδ : hệ số cung cực từ, chọn ở 2.5

τ : bước cực, tính ở 2.6

25

l1 : chiều dài lõi sắt stato, tính ở 2.5

### 3.10. Sơ bộ chiều rộng của răng (bZ1):

bz1

′ =

Bδ.l1.t1
Bz1.l1.kc

=

0,563.0,855
1,75.0,96

= 0,286(cm)

trong đó :

BZ1: mật độ từ thông ở răng stato, Theo bảng 10.5b [1] chọn

BZ1=1,75 T
kc : hệ số ép chặt lõi sắt, kc = 0,96

### 3.11. Sơ bộ chiều cao gông stato (hg1):

ℎg1

′ =

Φ.10

4

2.Bg1.l1kc

=

0.006495.10

4

2.1,51.11,7.0,96

= 1,91(cm)

trong đó :

Bg1: mật độï từ thông ở gông stato, theo bảng 10.5a [1] chọn Bg1=1,51 (T)

φ: từ thông khe hở không khí, tính ở 3.8

### 3.12. Kích thước rãnh stato:

hr1 = 1,69 (cm)

h12 = 1,24 (cm)

d1 = 0,63 (cm)

d2 = 0,8 (cm)

b41 = 0,22 (cm)

h41 = 0,05 (cm)

Hình 3.2. rãnh stato
Trong đó :

d1 =

π. (D + 2ℎ41) − b

′
z1. Z1
Z1 − π

=

π. (9,8 + 2.0,05) − 0,286.36 36 − π

= 0,633(cm)
( | ) | ( | )
' | '
1 | 1 1
2
1
2 | . 17 2.1,91 | 0,286.36
0,795( | )
| 36
D | h | b Z n | g | Z d | cm

Z

π | π
π | π
− | − | − | −
= | = | =
+ | +

ℎr1

=

| Dn − D
| 2

− ℎg1

′ | =
| | 17 − 9,8
2
| | | − 1,91 = 1,69(cm)

ℎ12 = ℎr1 −

d2
2
| | − ℎ41 = 1,698 −

0,8
2
| | | − 0.05 = 1,24(cm)

Tiết diện rãnh stato:

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
π. (d1

2 + d2

2
)
8

+

d1 + d2
2

. (ℎ12 −

d1
2

)

=

π. (6, 3

2 + 8

2
)
8

+

6,3 + 8
2

. (12,4 −

6,3
2

) = 106(mm²
)

Diện tích cách điện của rãnh stato

Scd = c. (2. ℎ12 + π.

d2r
2

+ d1r + d2r) +

π.
2

d1r

. c

′

= 0,4. (2.12,4 +

π. 8
2

+ 6,3 + 8) +

π. 6,3
2

0.5 = 25(mm²
)

Trong đó:

c, c'

là chiều dày cách điện rãnh, theo bảng VIII.1 ở phụ lục VIII [1] ta có

c = 0,4 mm, c' = 0,5 mm.

Diện tích có ích rãnh stato (Sr1): Sr1 = Sr

′ − Scd = 106 − 25 = 81(mm² )

Hệ số lấp đầy rãnh (kld):

kld =

ur

. n1. dcd

2

Sr1

=

54.2.0,75

2
81 = 0,75

### 3.13. Bề rộng răng stato (bZ1):

bZ1

∗ =

π. (D + 2. ℎ41 + d1)
Z1

− d1

=

π. (9,8 + 2.0,05 + 0,63)
36 | − 0,63 = 0,289(cm)

bZ1

∗∗ =

π. (D + 2. (ℎ41 + ℎ12))
Z1

− d2

=

π. (9,8 + 2. (0,05 + 1,24))
36 | − 0,8 = 0,28(cm)

bZ1 =

bZ1

∗ + bZ1

∗∗
2
= | 0,289 + 0,28
2
| = 0,285(cm)

### 3.14. Chiều cao gông stato (hg1):

ℎg1 =

Dn − D
2

− ℎr1 +

1
6

. d2

=

17 − 9,8
2

− 1,69 +

1
6

. 0,8 = 2,043(cm)

27

### 3.15. Khe hở không khí (δ):

Khi chọn khe hở không khí δ ta cố gắng lấy nhỏ để dòng điện không tải nhỏ

và cosφ cao, nhưng khe hở quá nhỏ làm cho việc chế tạo và lắp ráp thêm khó

khăn, stato dể chạm với rôto làm tăng thêm tổn hao phụ và điện kháng tản tạp

của máy cũng tăng.
Theo kết cấu thì khe hở phụ thuộc vào kích thước đường kính ngoài rôto,

khoảng cách giữa hai ổ bi và đường kính trục. Nguyên nhân là đường kính D

ảnh hưởng đến dung sai lắp ghép của vỏ, nắp, lõi sắt, từ đó quyết định độ lệch

tâm cho phép và lực từ một phía của máy. Đường kính trục và khoảng cách giữa hai ổ bi quyết định độ võng của trục. Có thể dùng những công thức sau để chọn

hệ số khe hở của không khí:

Với những máy công suất P ≤ 20 kW:

Khi 2p ≥ 4 | δ = 0, 25 + D*10⁻³mm
Khi 2p = 2 | δ = 0, 3 + | mm

Với những máy công suất P > 20 kW:

δ =

D
| 1200 ∗ (1 +
| 9 2p
)mm

Trong các công thức trên, D tính theo mm. Trị số δ tính ra phải làm tròn

con số thứ hai sau dấu phẩy thành 0 hoặc 5.

Theo những máy đã chế tạo bảng 10.8 [1]:

Với h =112 mm ta có δ = 0,6mm = 0,06 cm

1000

1,5.D

28

CHƯƠNG 4

THIẾT KẾ RÔTO

Thiết kế dạng rãnh cũng là xác định diện tích rãnh (tức là diện tích thanh

dẫn của lồng sóc). Do điện trở r và điện kháng tản x của rôto có quan hệ với

hình dạng rãnh rôto, nên khi rôto đã thiết kế xong thì việc thiết kế dạng rãnh

rôto trực tiếp ảnh hưởng đến tính năng của máy. Ngày nay, với những máy có

chiều cao tâm trục h=50 – 250 mm thường lồng sóc được đúc bằng nhôm, trong

đó khi h = 50 – 250 mm thường đúc bằng áp lực, khi h ≥ 280 mm thì đúc rung

hay trọng lực. Rãnh trong hình 4. 1a thường dùng trong máy không đồng bộ

rôto lồng sóc có chiều cao tâm trục h ≤ 160mm, trong đó thường lấy b42 = 1mm,

h42 = 0,5 – 1mm, d1/d2= 6, 5 – 7, 5/4 – 6mm, hr1 = 10 – 20 mm.

Khi h ≥ 180mm dùng rãnh sâu hình ôvan như hình 4 -1b hoặc 4-1c, trong đó b42

= 1, 5mm, h42= 0, 5 – 1, 5mm, d1= d2= br2= 3, 5 – 6mm, hr2= 25 – 45mm. Máy càng lớn tốc độ càng cao thì br2 càng sâu.

Hình 4.1 Các dạng rãnh rôto lồng sóc. Ta chọn rãnh rôto hình quả lê với miệng rãnh b42 = 1 (mm).

hr2

d2

h12

d1

h42

hr2

h42 | b42 b42

d2

d1

h12

b42 h42

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
b) c)

29

### 4.1. Số rãnh Rôto (Z2):

Việc chọn số rãnh rôto lồng sóc Z2 là một vấn đề quan trọng vì khe hở

không khí của máy nhỏ, khi mở máy momen phụ do từ thông sóng bậc cao gây nên ảnh hưởng đến quá trình mở máy và ảnh hưởng cả đến đặc tính làm việc.

Để loại trừ momen phụ đồng bộ khi mở máy, cần chọn:

Z2≠Z1 | Z2≠0,5.Z1
Z2≠2.Z1 | Z2≠6.p.g | với g=1,2,3…
Để tránh momen đồng bộ khi quay ,ta chọn:
Z2≠6.p±2.p.g | Z2≠Z1±2.p
Z2≠2.Z1±2.p | Z2≠0,5±p

Z2≠Z1±p
Để tránh lực hướng tâm do momen không đồng bộ sinh ra trong khi quay

,cần chọn:

|Z2 − Z1 | |≠0,1,2
|Z2 − Z1 | |≠p,p+1
Z2 − Z1 | ≠2.p,2.p±1,2.p±2

|Z2 − Z1

|≠2.p

Dựa vào các điều kiện trên và bảng 10-6 trang 246 TKMĐ

Chọn Z2 = 28 rãnh.

### 4.2. Đường kính ngoài rôto

D

′ = D − 2. δ = 9,8 − 2.0,06 = 9,68(cm)

trong đó:

D: đường kính trong stato, tính ở 2.3

δ: khe hở không khí, chọn ở 3.15

### 4.3. Bước răng rôto (t2):

| t2 = π.D

′
Z2
| | = π. 9,68 28 = 1,086(cm)

30

### 4.4. Sơ bộ bề rộng răng rôto (bZ2):

bZ2

′ =

Bδ.l2.t2
BZ2. l2. kC

=

0,563.1,086
1,75.0,96 = 0,364(cm)

trong đó :

BZ2: mật độ từ thông ở răng rôto, theo bảng 10.5b [1] chọn BZ2 =1,75 T kc : hệ số ép chặt lõi sắt, kc = 0,96

Bδ : mật độ từ thông khe hở không khí, tính ở 3.9

t2 : bước răng rôto, tính ở 4.3
l2 : chiều dài lõi sắt rôto, tính ở 2.5

### 4.5. Đường kính trục rôto (Dt):

Dt = 0,3.D = 0,3.9,8 = 2,94(cm)

### 4.6. Dòng điện trong thanh dẫn rôto (Itd):

Itd = I2 = kI

.I1.

6. w1. kd
Z2

= 0,89.0,872.

6.162.0,923
28 = 224,483(A)

trong đó:
Hệ số kI lấy theo hình 10-5 [3] : kI = 0.89

kd : hệ số dây quấn stato, tính ở 3.7

Z2 : số rãnh rôto

### 4.7. Dòng điện trong vành ngắn mạch (Iv):

IV = Itd.

1
2. sin π. P
Z2

= 224,483.

1
2. sin 180
0. 1
28

= 1002,474(A)

### 4.8. Tiết diện thanh dẫn bằng nhôm (Std):

Đối với động cơ không đồng bộ rôto lồng sóc, tiết diện rãnh rôto đồng

thời là tiết diện thanh dẫn rôto, vì vậy phải làm sao cho mật độ dòng điện trong

thanh dẫn rôto thích hợp.

Std =

Itd
J2

=

224,483
3,5

= 64(mm²
)

Trong đó :

31

J2 là mật độ dòng điện thanh dẫn rôto, lấy J2 = 3,5 (A/mm² )
Itd dòng điện trong thanh dẫn, tính ở 4.6

### 4.9. Tiết diện vành ngắn mạch( SV):

Chọn mật độ dòng điện trong vành ngắn mạch ở [1]

JV = 2,5 (A/mm²
)
Tiết diện vành ngắn mach (SV):

SV =

IV
JV

=

1002,474
2,5

= 401(mm²
)

### 4.10. Sơ bộ chiều cao gông rôto (hg2):

ℎg2 =

Φ. 10

4
2. Bg2. l2. kc

=

0,006495.10

4
2.1,51.11,7.0,95 = 1,81 (cm)

trong đó:

Bg2: mật độï từ thông ở gông rôto, theo bảng 10.5a [1]

chọn Bg2 = 1,51(T)

φ: từ thông khe hở không khí, tính ở 3.8

### 4.11. Kích thước rôto:

hr2 = 1,56 (cm)

h12 = 0,98 (cm)

d1r = 0,64 (cm)

d2r = 0,42 (cm)

b42 = 0,1 (cm)

h41 = 0,05 (cm)

Với : ℎr2 =

D

′−Dt

2

− ℎg2 =

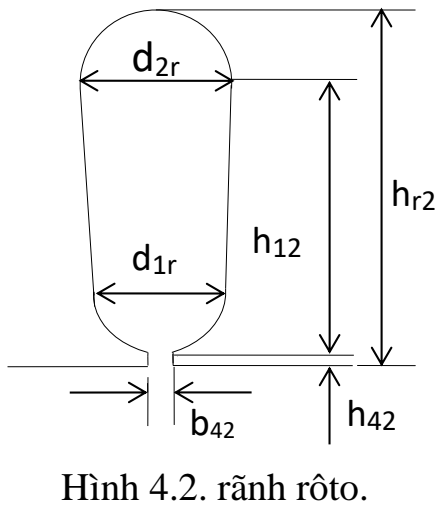
[picture p8: figure]
Hình 4.2. rãnh rôto.

9,68−2,94
2

− 1,81 = 1,56(cm)

d1r =

π.D

′ − 2π. ℎ42 − bZ2. Z2
π + Z2

=

π. 9,68 − 2. π. 0,05 − 0,364.28 28 + π

= 0,64(cm)

d2r =

π.D

′ − 2π. ℎr2 − bZ2

′
. Z2
Z2 − π

=

π. 9,68 − 2π. 1,56 − 0,364.28 28 − π

= 0,42(cm)

ℎ12 = ℎr2 −

d1
2

−

d2
2

− ℎ42 = 1,56 −

0,64
2

−

0,42
2

− 0,05 = 0,98(cm)

32

### 4.12. Kích thước vành ngắn mạch:

Chiều cao vành ngắn mạch thường lấy cao hơn chiều cao rãnh rôto:

a ≥ 1,2.hr2 = 1,2.15,6 = 1,872 (cm) = 18,72 (mm)

b = SV
a

=

401
18,72

= 21,42(mm)

Lấy : a = 20 mm

b = 20mm
Đường kính vành ngắn mạch:

DV = D − (a + 1) = 98 − (20 + 1) = 77(mm) Tiết diện vành ngắn mạch:
SV = a. b = 20.20 = 400(mm²
)

### 4.13. Diện tích rãnh rôto (Sr2):

Sr2 =

π. (d1

2 + d2

2
)
8

+

d1 + d2
2

. (ℎ12 −

d2
2

)

=

π. (0,64

2 + 0,42

2
)
8

+

0,64 + 0,42
2

. (0,98 −

0,42
2

)

= 0,64(cm²

) = 64(mm²
)

### 4.14. Chiều cao gông rôto (hg2):

ℎg2 =

D

′−Dt

2

− ℎr2 +

1
6

. d1r

=

9,68 − 2,94
2

− 1,56 +

1
6

. 0,64 = 1,916(cm)

### 4.15. Bề rộng răng rôto:

bZ2

∗ =

π. (D

′ − 2. ℎ42 − dr1)
Z2

− dr1

=

π. (9,68 − 2.0,05 − 0,64)
28 | − 0,64 = 0,363(cm)

bZ2

∗∗ =

π. (D

′ − 2. ℎr2 + dr2)
Z2

− dr2

=

π. (9,68 − 2.1,56 + 0,42)
28 | − 0,42 = 0,363(cm)

bZ2 =

bZ2

∗ + bZ2

∗∗
2
= | 0,363 + 0,363
2
| = 0,363(cm)

33

34

CHƯƠNG 5

TÍNH TOÁN MẠCH TỪ VÀ XÁC ĐỊNH THAM SỐ

CỦA ĐỘNG CƠ ĐIỆN Ở CHẾ ĐỘ ĐỊNH MỨC

### 5.1. TÍNH TOÁN MẠCH TỪ:

### 5.1.1. Hệ số khe hở không khí (kδ):

Do bề phần ứng có rãnh dẫn đến từ dẫn trên khe hở củabề mặt phần ứng

có rãnh khác nhau.

Trên răng, từ trở nhỏ hơn trên rãnh do sức từ động khe hở không khí của phần ứng có răng rãnhlớn hơn so với bề mặt phần ứng nhẵn.

Khi thiết kế phải dung một khe hở không khí tính toán, như vậy cấn phải tính hệ

số khe hở không khí. Hệ số khe hở không khí nói lên ảnh hưởng của răng stato

và rato tới khe hở.

Hệ số khe hở không khí stato(kδ1):

kδ1 =

t1
t1 − v1. δ

=

0,855
0,855 − 1,551.0,06 = 1,122

trong đó:

t1 : bước rãnh stato, tính ở 3.2

δ : khe hở không khí, tính ở 3.15

v1 =

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
0,22
0,06)

2

5 +

0,22
0,06

= 1,551

Với : b41 là bề rộng miệng rãnh stato, tính ở 3.12

Hệ số khe hở không khí rôto (kδ2):

kδ2 =

t2
t2 − v2. δ

=

1,086
1,086 − 0,416.0,06 = 1,023

trong đó

t2 là bước rãnh rôto , tính ở 4.3

ν2 =

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
0,035)

2

5 +

0,1
0,06

= 0,416

35

Với : b42 là miệng rãnh rôto, tính ở 4.11 Hệ số khe hở không khí:

kδ = kδ1 . kδ2 = 1,122 . 1,023 = 1,1478

### 5.1.2. Dùng thép kỹ thuật điện cán nguội 2411

### 5.1.3. Sức từ động khe hở không khí (Fδ):

Fδ = 1,6.Bδ. kδ. δ. 10

4

= 1,6 . 0,563 . 1,1478 . 0,06 . 10⁴

= 620,362 (A)

trong đó :

Bδ : mật độ từ thông khe hở không khí, tính ở 3.9

kδ : hệ số khe hở không khí

### 5.1.4. Mật độ từ thông ở răng stato (BZ1):

BZ1 =

Bδ. l1.t1
bZ1. l1. kC

=

0,563.0,855
0,285.0,96 = 1,759(T)

trong đó :

Bδ: Mật độ từ thông khe hở không khí, tính ở 3.9

t1: bước rãnh stato, tính ở 3.2
bZ1 : bề rộng răng stato, tính ở 3.13

l1 : chiều dài lõi sắt stato

### 5.1.5. Cường độ từ trường trên răng stato

Theo bảng V.7 ở phụ lục V [1] có: Hz1 = 23 (A/cm)

### 5.1.6. Sức từ động trên răng stato (FZ1):

FZ1 = 2. ℎZ1

′
. HZ1 = 2.1,423.23 = 65,458(A) trong đó:

ℎZ1

′ = ℎr1 −

d2
3

= 1,69 −

0,8
3

= 14,23(mm) = 1,423(cm)

### 5.1.7. Mật độ từ thông ở răng rôto:

BZ2 =

Bδ.l2.t2
bZ2. l2.t2

=

0,563.1,086
0,363.0,96 = 1,754(T)

trong đó :

36

Bδ: Mật độ từ thông khe hở không khí, tính ở 3.9

t2: bước rãnh rôto, tính ở 4.3
bZ2 : bề rộng răng rôto, tính ở 4.15

l2 : chiều dài lõi sắt rôto, tính 2.5

### 5.1.8. Cường độ từ trường trên răng rôto :

Theo bảng V.7 ở phụ lục V [1] có: Hz2 = 23 (A/cm)

### 5.1.9. Sức từ thông trên răng rôto:

FZ2 = 2. ℎZ2

′
. HZ2

= 2.1,346.23 = 61,916(A)
trong đó:

ℎZ2

′ = ℎr2 −

d1r
3

= 15,6 −

6,4
3

= 13,46(mm) = 1,346(cm)

### 5.1.10. Hệ số bảo hoà răng:

kz =

Fδ + FZ1 + FZ2
Fδ

=

620,362 + 65,458 + 61,916
620,362 | = 1,2059

trong đó:

Fδ : sức từ động khe hở không khí.

FZ1: sức từ động trên răng stato.

FZ2: sức từ động trên răng rôto

### 5.1.11. Mật độ từ thông trên gông stato (Bg1):

Bg1 =

φ. 10

4
2. ℎg1. l1. kC

=

0,006495.10

4
2.2,043.11,7.0,96 = 1,415(T)

trong đó:

φ : từ thông khe hở không khí, tính ở 3.8 hg1: chiều cao gông stato, tính ở 3.14

37

kC: hệ số ép chặt.

### 5.1.12. Cường độ từ trường ở gông stato :

Theo bảng V.10 ở phụ lục V [1] có: Hg1 = 4,4 (A/cm)

### 5.1.13. Chiều dài mạch từ ở gông stato (Lg1):

Lg1 =

π. (Dn − ℎg1)
2p

=

π. (17 − 2,043)
2

= 23,494(cm)

trong đó :

Dn : Đường kính ngoài stato, tính ở 2.2 p : số đôi cực.

### 5.1.14. Sức từ động ở gông stato:

Fg1 = Lg1. Hg1 = 23,506.4,4 = 103,373(A)

### 5.1.15. Mật độ từ thông trên gông rôto:

Bg2 =

φ. 10

4
2. ℎg2.l2. kc

=

0,006495.10

4
2.1,916.11,7.0,96 = 1,509(T)

trong đó:

φ : từ thông khe hở không khí, tính ở 3.8 hg2: chiều cao gông rôto, tính ở 4.14

kC: hệ số ép chặt.

### 5.1.16. Cường độ từ trường ở gông rôto

Theo bảng V.10 ỏ bảng phụ lục V [1] có: Hg2 = 8,2 (A/cm)

### 5.1.17. Chiều dài mạch từ ở gông rôto:

Lg2 =

π. (Dt + ℎg2)
2p

=

π. (2,94 + 1,916)
2

= 7,627(cm)

trong đó:

Dt : Đường kính trục, tính ở 4.5 hg2: chiều cao gông rôto, tính ở 4.14

### 5.1.18. Sức từ động trên gông rôto:

Fg2 = Lg2. Hg2 = 7,627.8,2 = 62,541(A)

38

### 5.1.19. Tổng sức từ động của mạch từ:

F = Fδ + Fz1 + FZ2 + Fg1 + Fg2

= 620,362 + 65,458 + 61,916 + 103,373 + 62,541

= 913,65 (A)

trong đó:

Fδ : sức từ động khe hở không khí, tính ở 5.1.3.

FZ1 : sức từ động trên răng stato, tính ở 5.1.6.

FZ2 : sức từ động trên răng rôto, tính ở 5.1.9.

Fg1 : Sức từ động trên gông roto, tính ở 5.1.14.

Fg2 : Sức từ động trên gông stato, tính ở 5.1.18.

### 5.1.20. Hệ số bão hoà toàn mạch (kµ):

| kμ = F Fδ =
| 913,65 620,362 = 1,472

trong đó:
F : Tổng sức từ động của mạch từ.

Fδ : sức từ động khe hở không khí, tính ở 5.1.3

### 5.1.21. Dòng điện từ hoá (Iµ):

Iμ =

| p. F 2,7. w1. kd1 = 1.913,65 2,7.162.0,923 = 2,263(A)

trong đó :
w1 : số vòng dây quấn 1 pha stato, tính ở 3.4

kd : hệ số dây quấn, tính ở 3.7

Dòng điện từ hoá phần trăm:

Iμ | 0
| 0 = Iμ Idm . 100% =
| 2,263 7,872 . 100% = 28,74%

### 5.2. THAM SỐ CỦA ĐỘNG CƠ ĐIỆN Ở CHẾ ĐỘ ĐỊNH MỨC

Điện trở và điện kháng của dây quấn là những tham số chủ yếu của máy

điện.
Điện kháng xác định bởi từ thông móc vòng của cảm ứng tương hổ xuyên

qua các khe hở không khí và móc vóng vào cả hai cuộn dây stato và roto

39

động cơ, sinh ra điện kháng cơ bản, đó là điện kháng hổ cảm. Từ thông

móc vòng tản chỉ móc vòng mỗi bản than cuộn dây, sinh ra điện kháng

tản x1 đối với stato và x2 đới với roto, x1+x2 là điện kháng tổng của dây

quấn động cơ.

Điện trở động cơ giúp xác định những tổn hao của dây quấn động cơ ở

chế độ xác lập và quá trình quá độ.

5.2. 1. Chiều dài phần đầu nối của dây quấn stato:

Ld1 = kd1.τy + 2.B = 1,2.15,04 + 2.1 = 20,048 (cm)

trong đó:

τy =

π.(D+ℎr1

).y

Z1

=

π.(9,8+1,69).15
36

= 15,04 (cm)

Với : hr1 là chiều cao rãnh stato, tính ở 3.12

### 5.2.2. Chiều dài trung bình nửa vòng dây của dây quấn stato:

Ltb = l1 + Ld1 = 11,7 + 20,048 = 31,748(cm)

### 5.2.3. Chiều dài dây quấn một pha của stato :

L1 = 2.Ltb .W1 .10⁻²

= 2 . 31,748 . 162 . 10⁻² = 102,863 (m)

### 5.2.4. Điện trở tác dụng của dây quấn stato:

r1 = ρ75 .

L1
n1.a1.s1

=

1
46 .

102,863
2.2.0,374 = 1,494(Ω)

trong đó:
ρ75: điện trở xuất của đồng ở 75o
[1]
n1 : số sợi chập

s1 : tiết diện dây dẫn chọn, chọn ở 3.5

L1: tính ở 5.2.3
a1 = 2 số mạch nhánh song song, chọn ở 3.3

Tính theo đơn vị tương đối:

r1

∗ = r1

I1
U1

= 1,494 ⋅

7,872
220 = 0,0534

40

### 5.2.5. Điện trở tác dụng của dây quấn rôto (rtd):

rtd = ρAl.

l2. 10

−2

Sr2

=

1
23 .

11,7.10

−2
64 = 0,794.10 −4
(Ω)

trong đó:
ρAl : điện trở suất của nhôm [1]

Sr2 : diện tích rãnh rôto, tính ở 4.13 l2 : chiều dài lõi sắt rôto, tính ở 2.5

### 5.2.6. Điện trở vành ngắn mạch (rV):

rv = ρAl

π.Dv. 10

−2
Z2. Sv

=

1
23 .

π. 7,7.10

−2
28.401 = 0,936.10

−6
(Ω)

trong đó:
DV : Đường kính vành ngắn mạch, tính ở 4.12.

SV ; diện tích vành ngắn mạch, tính ở 4.12.

### 5.2.7. Điện trở rôto (r2):

r2 = rtd +

2. rv
Δ² = 0,794.10

−4 +

2.0,00936.10

−4
0,223

2

= 1,169 .10⁻⁴
(Ω)
trong đó:

Δ = 2. sin

π. p
Z2

= 2. sin

180.1
28 = 0,223

### 5.2.8. Hệ số quy đổi :

γ =

4. m1. (w1. kd)

2
Z2

=

4.3. (162.0,923)

2
28
= 9582,01
trong đó:
kd : Hệ số dây quấn, tính ở 3.7

w1 : số vòng dây nối tiếp một pha, tính ở 3.7

### 5.2.9. Điện trở rôto đã quy đổi (r'2):

r2

,

= γ.r2 = 9582,01. 1,169.10⁻⁴ = 1,12 (Ω)

Tính theo vị trí tương đối

r2

,*
= r2

,

I1
U1

=1,12.

7,872
220

= 0,04(Ω)

41

### 5.2.10. Hệ số từ dẫn tản stato (λr1):

λr1 =

ℎ1
3b

. kβ + (0,785 -

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
) . k,
β

λr1 =

14,8
3.6,3

0.91 + (0,785 −

2,2
2.6,3

−

1,85
6,3

+

0,5
2,2

).0,875 = 1,188

trong đó:

β =

y
τr

=

15
18 = 0,833

kβ

′ =

1 + 3. β
4

=

1 + 3.0,833
4

= 0,875

kβ =

1
4

+

3
4

. k

'
β = 0,91

h1 = hr1 – 0,1 . d2 – 2.c-c

'
= 1,69 – 0,1 . 0,8 – 2 . 0,4 - 0,5

= 14,8 (mm)
- h2 = - ( d1
2
- 2.c ) = - ( 6,3
2
- 2 . 0,4 – 0,5) = -1,85 (mm)

b = d1 = 6,3 (mm)

b41 = 2,2 (mm)

### 5.2.11. Hệ số từ dẫn tạp stato:

λt1 = 0,9.

t1. (q1. kd)

2
. k41. ρt1
kδ. δ

= 0,9.

0,855. (6.0,923)

2
. 0,969.0,675
1,1478.0,06 | . 0,0045 = 1,008

trong đó:

k41 = 1 − 0,033 ⋅

b41

2
t1. δ

= 1 − 0,033 ⋅

0,22

2
0,855.0,06 = 0.969
Với : | kd : hệ số dây quấn

t1 : bước rãnh stato, tính ở 3.2 q1 : rãnh một pha dưới mỗi cực

### 5.2.12. Hệ số từ tản phần đầu nối:

λđ1 = 0,34 .q1
l1

.( Lđ1 – 0,64 . β . τ )

= 0,34 . 6
11,7

. ( 20,048 – 0,64 . 0,833.15,393 ) = 2,026

trong đó:

42

l1 : chiều dài lõi sắt stato, tính ở 2.5

τ : bước cực, tính ở 2.6

### 5.2.13. Hệ số từ dẫn tản stato:

Σλ1 = λr1 + λt1 + λđ1

= 1,188 + 1,008 + 2,026 = 4,222

trong đó:
λr1 : hệ số từ dẫn tản, tính ở 5.2.10

λt1 : hệ số từ dẫn tạp, tính ở 5.2.11

λđ1 : hệ số từ tản dầu nối, tính ở 5.2.12

### 5.2.14. Điện kháng dây quấn stato:

x1 = 0,158 . f1
100

. (

w1
100

)

2

l1
p.q1

. ∑ λ1

= 0,158 . ⁵⁰
100

. (

162
100

)

2

11,7
2.3

. 4,222 = 1,706(Ω)

trong đó:
Σλ1 :hệ số từ tản stato, tính ở 5.2. 13.

l1 : chiều dài lõi sắt stato, tính ở 2.5

Tính theo đơn vị tương đối:

x1

∗ = x1 ⋅

I1
U1

= 1,706 ⋅

7,872
220 = 0,061

### 5.2.15. Hệ số từ dẫn tản rôto:

λr2 = [ℎ1
3.b

. ( 1 -

π.b

2

8.Sr

)

2
+ 0,66 -

b42
2.b

] + ℎ42
b42
= [
11,26
3.6,4

. (1 −

π.6,4
8.64 )

2
+ 0,66 −

1
2.6,4

] +
0,5
1

= 1,41

trong đó:

h1 = h12 +

d2
2

1
10

. d1 = 9,8 + 4,2
2
- 0,1.6,4 = 11,26(mm)

b = d1 = 0,64 (cm) = 6,4 (mm) Sr = 64 (mm²
), tính ở 4.13

b42 = 1 (mm), tính ở 4.11

h42 = 0,5 (mm), tính ở 4.11

43

### 5.2.16. Hệ số từ dẫn tạp rôto (λt2 ) :

λt2 = 0,9.

t2. (q2. kδ2)

2
. k42. ρt2
kδ. δ

. σ2

= 0,9.

1,086. (

28
3.2

. 1,023)

2
. 1.1
1,1478.0,06 . 0,0042 = 1,358

trong đó:

t2 : bước rãnh rôto, tính ở 4.3.
q2 : rãnh một pha dưới mỗi cực

kσ2: hệ số khe hở không khí, tính ở 5.1.1.

δ : khe hở không khí, chọn ở 3.15.

### 5.2.17. Hệ số từ tản phần đầu nối:

λđ2 =

2,3.DV Z2.l2.Δ² | . lg⁴,7.DV a+2.b

=

2,3.7,7 28.15.0,0223

2 . lg | 4,7.7,7 2 + 2.2 = 0,848

trong đó:

DV, a, b : tính ở 4.12

### 5.2.18. Hệ số từ tản rôto:

Σλ2 = λr2 + λt2 + λđ2

= 1,41 + 1,358 + 0,848 = 3,616

### 5.2.19. Điện kháng tản dây quấn rôto (x2):

x2 = 7,9 . f1 . l2 . Σλ2 . 10⁻⁸

= 7,9 . 50 . 11,7. 3,616 . 10⁻⁸ =1,67 .10⁻⁴ (Ω)

trong đó:
f1 : tần số định mức.

Σλ2: hệ số từ tản rôto, tính ở 5.2.18

L2: chiều dài lõi sắt rôto, tính ở 2.5

### 5.2.20. Điện kháng rôto đã quy đổi : (x'2)

x

'

2 = γ . x2 = 9582,01 .1,67.10⁻⁴
| = 1,6 ( Ω)

trong đó:

44

γ : hệ số quy đổi, tính ở 5.2.8

x2:điện kháng tản dây quấn rơto, tính ở 5.2.19

Tính theo vị trí tương đối (x2
*
):

x2

*
= x2 .

I1
U1

= 1,6 .⁷,872
220

= 0,057

### 5.2.21. Điện kháng hổ cảm (x12):

x12 =

U1 − Iμ. x1
Iμ

=

220 − 2,263.1,706
2,263 | = 95,51(Ω)

trong đó:

U1 : điện áp định mức

Iµ : dòng điện từ hoá, tính ở 5.1.21.
x1 : điện kháng dây quấn statos, tính ở 5.2. 14.

Tính theo đơn vị tương đối:

x12

* = x12 .

I1
U1

= 95,51. 7,872
220

= 3,417

### 5.2.22. Tính lại kE :

kE =

U1−Iμ.x1
220

=

220−2,263.1,706
220

= 0,982

trong đó:

U1 : điện áp định mức

Iµ : dòng điện từ hoá, tính ở 5.1.21.
x1 : điện kháng dây quấn stato, tính ở 5.2.14.

Trị số này không sai khác nhiều so với trị số ban đầu nên không cần tính

lại.

### 5.3. TỔN HAO THÉP VÀ TỔN HAO CƠ

Tổn hao sinh ra trong quá trình làm việc của máy điện về bản chất gắn

liền với quá trình điện từ trong máy và chuyển động cơ của rôto. Tổn hao trong

máy càng nhiều thì hiệu suất của máy càng thấp. Mặt khác tổn hao thoát ra dưới

dạng nhiệt làm nóng máy, trong một chừng mực nhất định làm giảm tuổi thọ và

độ tin cậy của cách điện trong máy
Tổn hao trong máy động cơ điện có thể phân thành những loại sau:

45

Tổn hao trong sắt ở stato và rôto do từ trễ và dòng điện xoáy khi từ

thông chính biến thiên. Ngoài ra trong tổn hao sắt còn tính đến các tổn hao phụ

gọi là tổn hao bề mặt và tổn hao đập mạch do sự thay đổi từ trễ và sự thay đổi

lần lượt vị trí tương đối của rãnh stato và rôto.

Tổn hao trong đồng do hiệu ứng Jun gây nên trong dây quấn và ở nơi

tiếp xúc giữa chổi than và vành góp hoặc vành trượt.

Tổn hao phụ khi có tải do sự đập mạch của từ thông tản ở động cơ điện

xoay chiều hoặc do sự biến dạng của từ trường phản ứng phần ứng và từ trường

của phần tử đổi chiều ở động cơ điện một chiều.

Tổn hao cơ: do ma sát ở vòng bi, ma sát giữa chổi than với vành góp hay

vành trượt và ma sát giữa không khí với các bộ phận quay. Tổn hao trên quạt

gió cũng kể vào tổn hao cơ.

Ở những động cơ điện làm việc với điện áp và tốc độ quay không đổi, khi

chuyển từ chế độ làm việc không tải đến chế độ tải định mức, tổn hao thép và

tổn hao cơ thay đổi rất ít, vì vậy tổn hao này gọi là tổn hao không tải

Các tổn hao trong đồng và tổn hao phụ khi có tải gọi là tổn hao khi có tải vì

chúng biến đổi theo tải.

### 5.3.1. Trọng lượng răng stato:

GZ1 = γFe . Z1 . bZ1 . h'

Z1 . l1 . kc1 . 10⁻³

= 7,8 . 36 . 0,285 . 1,423 . 11,7 . 0,96 . 10⁻³ = 1,279 (kg)

trong đó:
Z1 : số răng stato, tính ở 3.1

bZ1 : chiều rộng răng stato, tính ở 3.10.

h

'
Z1 = hr1 – d2/3=1,69 – 0,8/3 = 1,423 (cm) với hr1, tính ở 3.12 kc : hệ số ép chặt

### 5.3.2. Trọng lượng gông từ stato :

Gg1 = γFe . l1 . Lg1 . hg1 . 2 . p . kc . 10⁻³

= 7,8 . 11,7 . 23,494 . 2,043 . 2 .1 . 0,96 . 10⁻³ = 8,41 (kg)

trong đó:

46

l1 : chiều dài lõi sắt, tính ở 2.5

Lg1: chiều dài mạch từ ở gông stato, tính ở 5.1.13.

hg1 : chiều cao gông stato, tính ở 3.11.

kc : hệ số ép chặt

p : số đôi cực từ

### 5.3.3. Tổn hao sắt trong lõi sắt stato:

Tổn hao chính trong thép vì từ trễ và dòng điện xoáy xuất hiện đồng thời.

Nguyên nhân là do dòng điện từ hoá chạy trong thép khi từ trường biến đổi .

Tổn hao phụ trong thép sinh ra bởi dòng điện xoáy và hiện tượng từ trễ trong

máy trong thép ở phần răng và trên bề mặt stato và rôto tạo nên bởi các sóng

điều hoà bậc cao và sóng điều hoà răng của từ trường stato và rôto

Trong răng:

PFeZ1 = kgc . PFeZ . B²

Z1 . GZ1 . 10⁻³

= 1,8 . 2,5 . 1,759² . 1,279 . 10⁻³ = 0,0178 (kW)

trong đó:
PFeZ : suất tổn hao thép trong răng [1] trang 618.

kgc : hệ số gia công [1] trang 140

GZ1 : trọng lượng răng phần ứng, tính ở 5.3.1.

BZ1 : mật độ từ thông ở răng stato, tính ở 5.1.4.

Trong gông:

PFeg1 = kgc' . PFeg1 . B²

g1 . Gg1 . 10⁻³

= 1,6 . 2,5 . 1, 415² . 8,41 . 10⁻³ = 0,067 (kW)

trong đó:
PFeZ : suất tổn hao thép trong gông [1] trang 618.

kgc : hệ số gia công[1] trang 140.

Gg1 : trọng lượng gông phần ứng, tính ở 5.3.2.

BZ1 : mật độ từ thông ở gông stato, tính ở 5.1.4. Trong cả lõi sắt stato:

P'Fe = PFeZ1 + PFeg1

47

= 0,0178 + 0,067 = 0,0848 (kW) 5.3.4.Tổn hao bề mặt trên răng rôto:

Khi máy điện quay, đối diện với răng roto của máy không đồng bộ lần

lượt xuất hiện sự dao động của mật độ từ thông, biên độ dao động của từ thông

càng lớn thì khe hở không khí càng nhỏ và miệng rãnh càng to. Tần số dao động

phụ thuộc vào số răng và tốc độ quay .

Vì tần số dao động cao nên các dòng điện xoáy cảm ứng trong thép điếu

tập trung lên lớp mỏng trên bề mặt lõi thép, vì vậy tổn hao gây nên bởi các dòng

điện xoáy này được gọi là tổn hao bề mặt.

Ở máy điện không đồng bộ, tổn hao bề mặt lớn vì khe hở không khí nhỏ. Tổn

hao chủ yếu đập trung trên bề mặt roto còn trên bề mặt stato ít hơn do miệng

rãnh roto bé.

Pbm = 2 . p . τ .

t2−b42
t2

. L2 . P'bm . 10⁻⁷

= 2.1 . 15,393 .¹,086−0,1
1,086

. 11,7. 47,286 . 10⁻⁷

= 0,0015 (kW)

trong đó:

τ : bước cực, tính ở 2.6.

t2 : bước răng, tính ở 4.3.
P'bm: Suất tổn hao trung bình trên một đơn vị (m²

) bề mặt stato :

P'bm = 0,5 . k0 . ( Z1.n1
10000

)

1,5 . (10 . B0 . t1)

2

= 0,5 .2 . (³⁶.3000
10000

)

1,5 . (10 . 0,135 . 0,855)² = 47,286

Với : k0 : hệ số kinh nghiệm

B0 : biên độ dao động của mật độ từ thông tại khe hở không khí

B0 = β0 . kδ . Bδ = 0,21 . 1,1478 . 0,563 = 0,135 (T)

β0 : tra theo hình 6-1 [1]

β0 | = 0,21
b41 δ | =
| 0,22
| 0,06 = 3,667

48

kδ : hệ số khe hở không khí, tính ở 5.1.1.

### 5.3.5. Tổn hao đập mạch trên răng rôto:

Trong các động cơ điện có răng rãnh trên cả stato và rôto như động cơ điện không đồng bộ và động cơ điện có cuộn cảm, ngoài tổn hao bề mặt còn có

tổn hao đập mạch do hiện tượng đập mạch đáng kể của mật độ từ thông trong

các răng. Nguyên nhân của sự đập mạch này là do dao động của từ trường trong vùng liên thông răng (rãnh) stato và rôto theo vị trí tương đối của rãnh stato và

rôto.

Pđm = 0,11. (

Z1.n1
10000

. 10.Bdm)

2
. GZ2 . 10⁻³

= 0,11 (

36.3000
10000

. 10.0,075)

2
. 1,248.10

−3 = 0,009(kW)

trong đó:

Bdm =

ν1.δ
2.t2

.BZ2 =

1,551.0,06
2.1,086

. 1,754 = 0,075(T)

BZ2 : mật độ từ thông ở răng rôto, tính ở 5.1.7.

Trọng lượng răng rôto:

GZ2 = γFe . Z2 .h'Z2 . bZ2 . L2 . kc .10⁻³

= 7,8 . 28 . 1,346 . 0,363 . 11,6 . 0,96 . 10⁻³= 1,237 (kg)

### 5.3.6. Tổng tổn hao thép:

PFe = P'Fe + Pbm + Pđm

= 0,0848 + 0,0015 + 0,009= 0,095 (kW)

trong đó:
P'Fe: tổn hao cả lõi sắt stato, tính ở 5.3.3

Pbm : tổn hao bề mặt trên răng rôto, tính ở 5.3.4

Pđm : tổn hao đập mạch trên răng rôto, tính ở 5.3.5.

### 5.3.7. Tổn hao cơ:

Tổn hao cơ hay tổn hao ma sát phụ thuộc vào áp suất trên bề mặt ma sát,

hệ số ma sát và tốc độ chuyển động tương đối của bề mặt ma sát. Việc tính toán

49

các tổn hao này gặp khó khăn ở phần xác định hệ số ma xát vì hệ số này phụ

thuộc vào chất lượng bề mặt ma sát, loại dầu bôi trơn và nhiệt

Pcơ = k . (

n1
1000)

2
. (

Dn
10)

4
. 10

−3

= 1.079 (

3000
1000)

2
. (

17
10)

4
. 10

−3 = 0,081(kW)

trong đó:
k : xác định theo phần ứng Dn

n1 : tốc độ định mức.

Dn : đường kính ngoài stato, tính ở 2.2.

### 5.3.8. Tổn hao không tải :

P0 = PFe + Pcơ = 0,095 + 0.081 = 0,176 (kW)

50

KẾT LUẬN

Sau một thời gian làm việc khẩn trương và nghiêm túc, bản đồ án đã

hoàn thành các nhiệm vụ đặt ra cho việc tính toán thiết kế động cơ không đồng

bộ ba pha rôto lồng sóc công suất 4 kW; 2p = 2. Kết quả đạt được của bản đồ án

thỏa mãn các tiêu chuẩn kỹ thuật như:

cosφ = 0,92 yêu cầu là 0,

η = 86,51 yêu cầu là 86,5 %

Bội số mômen khởi động mk = 2,813; yêu cầu là 2,0.

Bội số mômen max mmax = 3,248 ; yêu cầu là 2,2.

Bội số dòng điện khởi động Ik

Idm

= 7,229; yêu cầu là Ik

Idm

= 7,5.

Các chỉ tiêu về vật liệu tác dụng đạt được cũng nằm trong phạm vi cho

phép so với các máy đã chế tạo tại Việt Nam.

51

TÀI LIỆU THAM KHẢO

[1] Trần Khánh Hà, Nguyễn Hồng Thanh; Thiết kế máy điện; Nhà xuất bản

khoa học kỹ thuật, Hà nội, 2006.
