dinhducqng/CDIO-4---Motor-3-Phase-AutoCad/(list of files, cad)

Other CAD files:
Drawing1.dwg
