dinhducqng/CDIO-4---Motor-3-Phase-AutoCad/demo lan 2.pdf

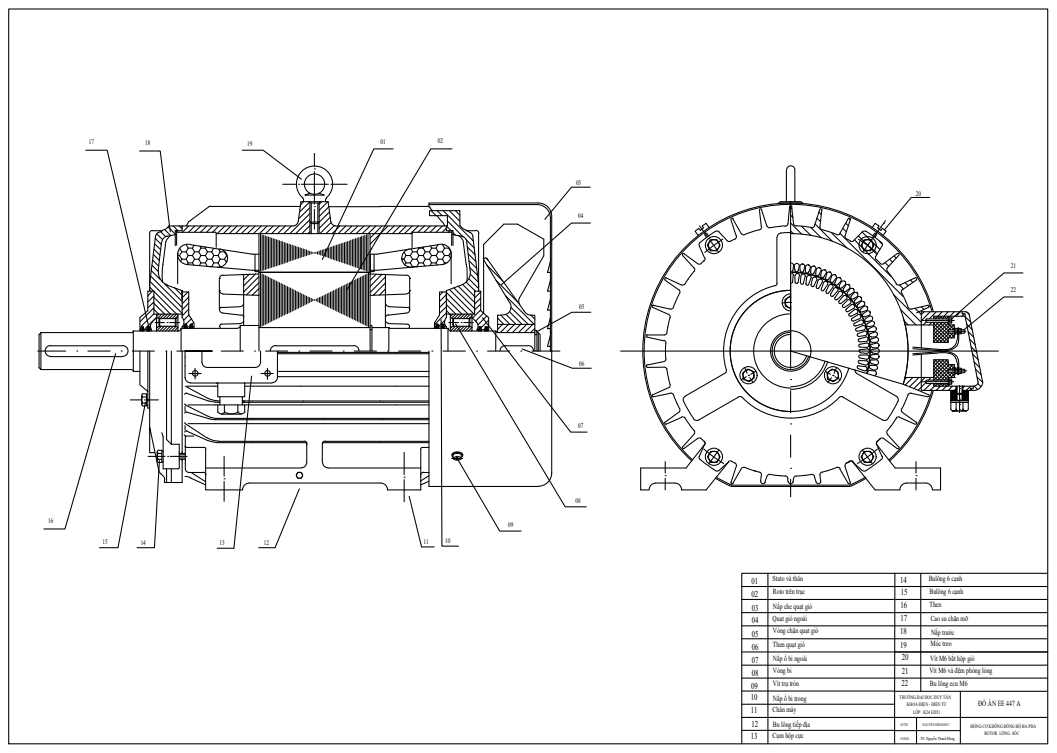
[picture p9: page 1]

02 | Stato và thân Roto trên trục Quạt gió ngoài | 15 | Bulông 6 cạnh Bulông 6 cạnh Then
01 | | 14

03 | Nắp che quạt gió | 16
04 | | 17
06 | Vòng chặn quạt gió | 19 | Móc treo Vít M6 bắt hộp gió Vít trụ tròn Cao su chặn mỡ Nắp trước Nắp ổ bi ngoài Then quạt gió
05 | | 18

09 | Vòng bi Nắp ổ bi trong | 22

07 | | 20
08 | | 21 | Bu lông ecu M6 Vít M6 và đệm phòng lỏng

10 | | TRƯỜNG ĐẠI HỌC DUY TÂN SVTH KHOA ĐIỆN - ĐIỆN TỬ LỚP : K24 EDT1 | ĐỒ ÁN EE 447 A
11 | Chân máy Bu lông tiếp địa
12 | | | NGUYỄN ĐÌNH ĐỨC | ĐỘNG CƠ KHÔNG ĐỒNG BỘ BA PHA ROTOR LỒNG SÓC
13 | Cụm hộp cực | GVHD | TS. Nguyễn Thanh Hùng
