dinhducqng/CDIO-4---Motor-3-Phase-AutoCad/demo lan 3.pdf

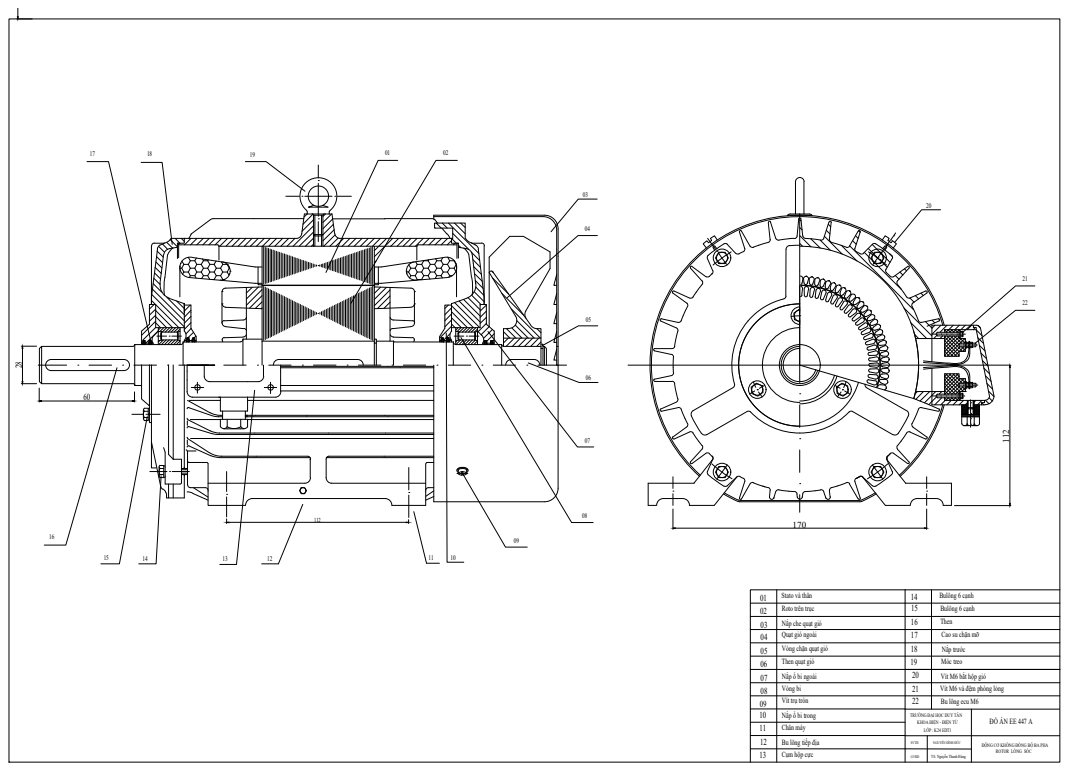
[picture p10: page 1]
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

03 | Nắp che quạt gió | 16
04 | Vòng chặn quạt gió | 17 | Cao su chặn mỡ Nắp trước
05 | | 18
07 | Nắp ổ bi ngoài Then quạt gió | 20 | Móc treo Vít M6 bắt hộp gió Vít trụ tròn
06 | | 19

09 | Vòng bi Nắp ổ bi trong | 22

08 | | 21 | Bu lông ecu M6 Vít M6 và đệm phòng lỏng

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
